williampsmith/speech_controlled_robot/README.md

# speech_controlled_robot
Contents of project aimed at designing and implementing a speech controlled robotic vehicle.
